aSmartCar/esp32driver-board/README.md

# ESP32Driver

This project is part of the ASV system and includes the custom PCB

## Specs
- Powersupply: 5.5 V - 36 V (depends on the voltage resistors)
- Microcontroller: ESP32
- USB to UART: FTDI FT231XQ
- Motorcontroller: Sparkfun DUALTB6612FNG
