aSmartCar/esp32driver-board/ESP32Driver_bottom.pdf

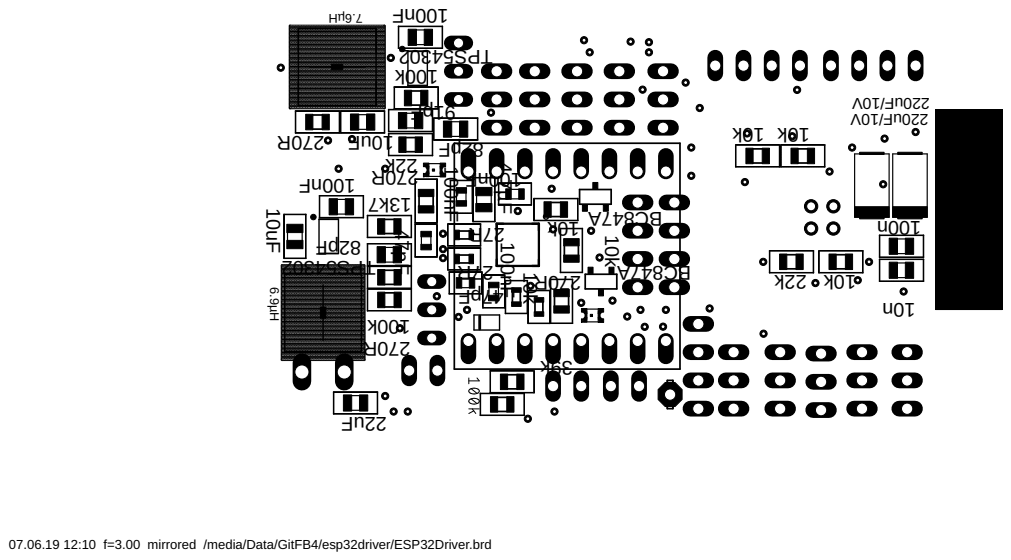
[picture p1: page 1]

07.06.19 12:10 f=3.00 mirrored /media/Data/GitFB4/esp32driver/ESP32Driver.brd
