aSmartCar/esp32driver-board/ESP32Driver_top.pdf

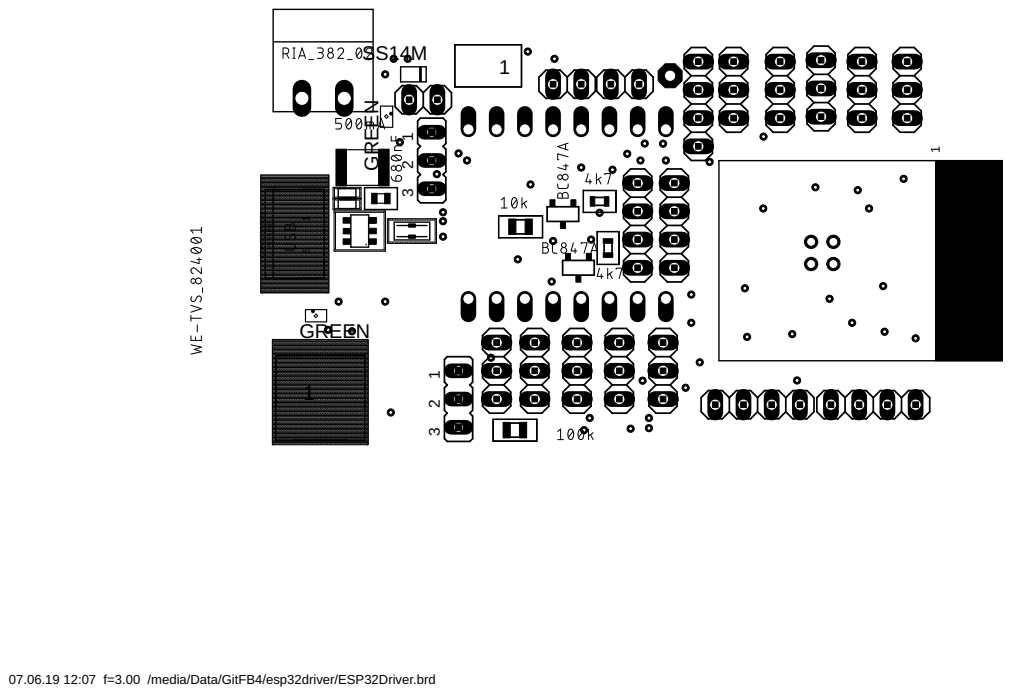
[picture p2: page 1]

PCB EDGE CONNECTOR EDGE 1
