aSmartCar/esp32driver-board/ESP32Driver.brd

## EAGLE design ESP32Driver.brd (2021-08-10)

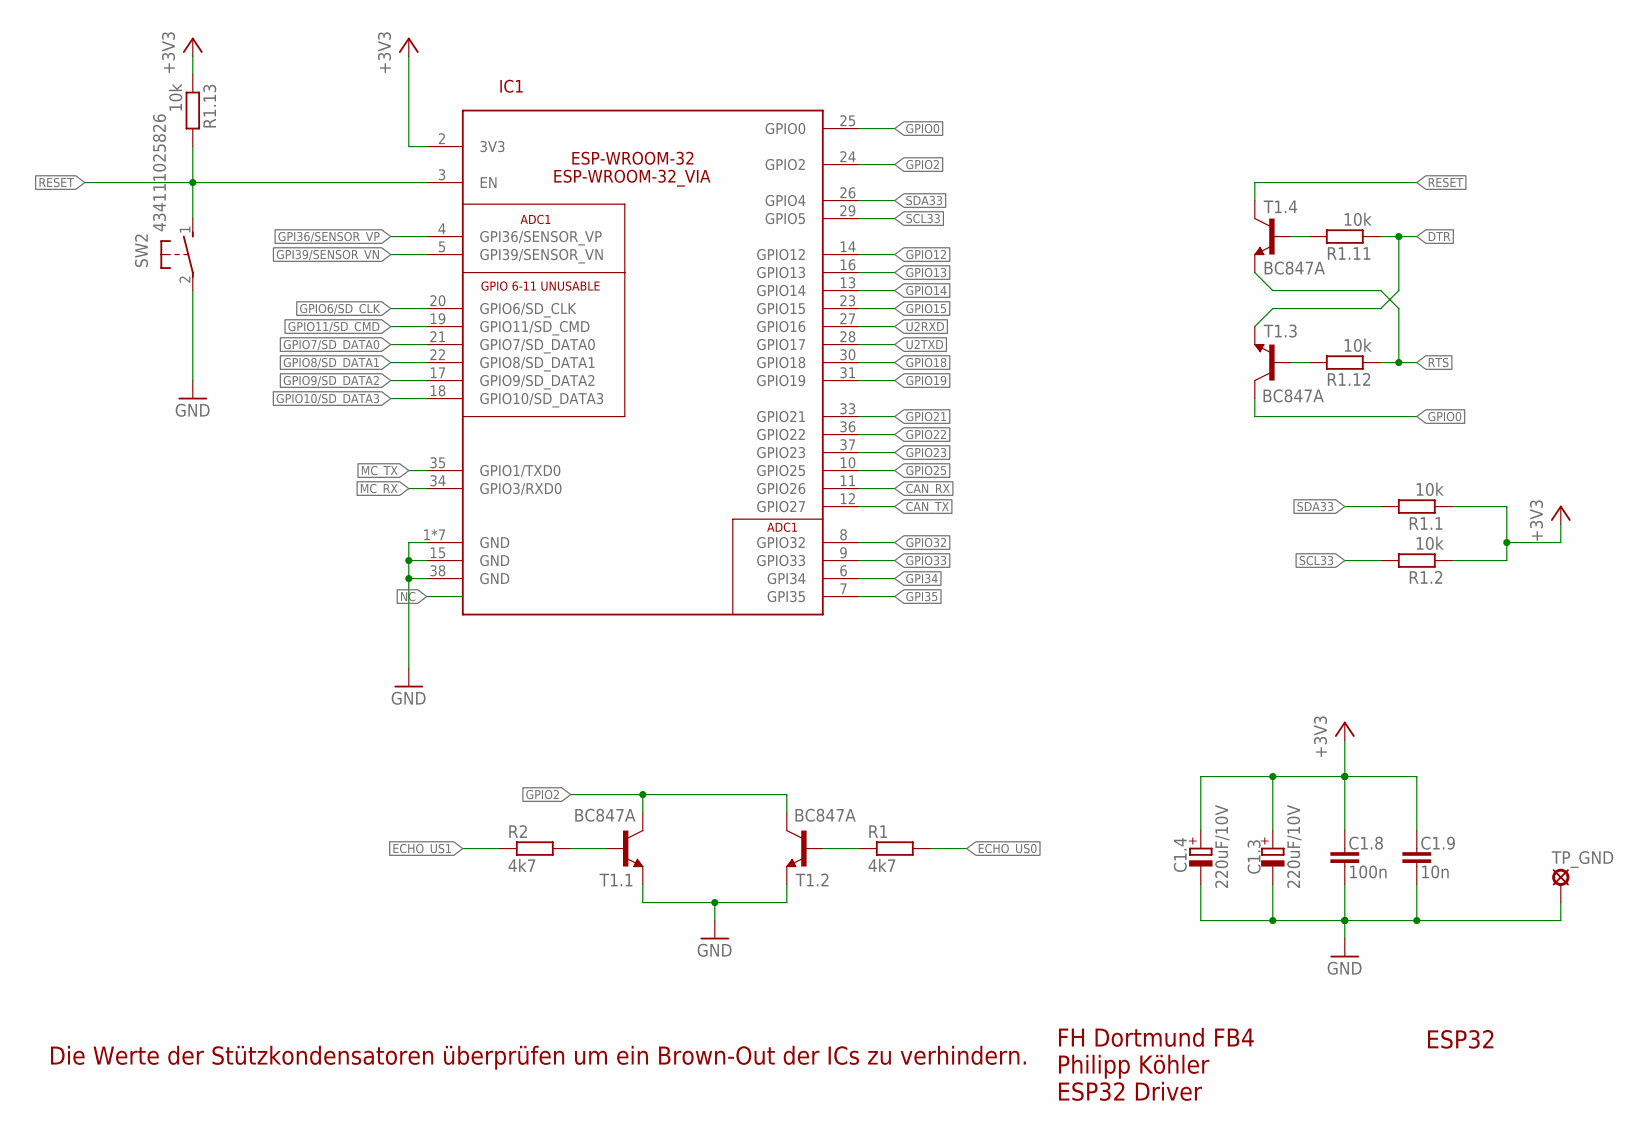
[picture p3: schematic ESP32Driver.sch, sheet 1, ESP32]

Parts:
C1.3, C1.4: 220uF/10V; SMC_C
C1.8: 100n; C0805
C1.9: 10n; C0805
IC1: ESP-WROOM-32_VIA; ESP-WROOM-32-VIA
R1, R2: 4k7; R0603
R1.1, R1.2, R1.11, R1.12, R1.13: 10k; R0805
SW2: 434111025826; 434121025816
T1.1, T1.2, T1.3, T1.4: BC847A; SOT23
TP_GND: GND; LSP10

Connections:
+3V3: C1.3.+, C1.4.+, C1.8.1, C1.9.1, IC1.2 (3V3), R1.1.1, R1.2.1, R1.13.1; also elsewhere on the board
CAN_RX: IC1.11 (GPIO26); also elsewhere on the board
CAN_TX: IC1.12 (GPIO27); also elsewhere on the board
DTR: R1.11.1, T1.3.2 (E); also elsewhere on the board
ECHO_US0: R1.2; also elsewhere on the board
ECHO_US1: R2.1; also elsewhere on the board
GND: C1.3.-, C1.4.-, C1.8.2, C1.9.2, IC1.1 (GND), IC1.15 (GND), IC1.38 (GND), IC1.THERMAL (GND), IC1.THERMAL1 (GND), IC1.T_VIA1 (GND), IC1.T_VIA2 (GND), IC1.T_VIA3 (GND), IC1.T_VIA4 (GND), SW2.2, T1.1.2 (E), T1.2.2 (E), TP_GND.MP; also elsewhere on the board
GPI34: IC1.6 (GPI34); also elsewhere on the board
GPI35: IC1.7 (GPI35); also elsewhere on the board
GPI36/SENSOR_VP: IC1.4 (GPI36/SENSOR_VP); also elsewhere on the board
GPI39/SENSOR_VN: IC1.5 (GPI39/SENSOR_VN); also elsewhere on the board
GPIO0: IC1.25 (GPIO0), T1.3.3 (C); also elsewhere on the board
GPIO2: IC1.24 (GPIO2), T1.1.3 (C), T1.2.3 (C)
GPIO6/SD_CLK: IC1.20 (GPIO6/SD_CLK)
GPIO7/SD_DATA0: IC1.21 (GPIO7/SD_DATA0)
GPIO8/SD_DATA1: IC1.22 (GPIO8/SD_DATA1)
GPIO9/SD_DATA2: IC1.17 (GPIO9/SD_DATA2)
GPIO10/SD_DATA3: IC1.18 (GPIO10/SD_DATA3)
GPIO11/SD_CMD: IC1.19 (GPIO11/SD_CMD)
GPIO12: IC1.14 (GPIO12); also elsewhere on the board
GPIO13: IC1.16 (GPIO13); also elsewhere on the board
GPIO14: IC1.13 (GPIO14); also elsewhere on the board
GPIO15: IC1.23 (GPIO15); also elsewhere on the board
GPIO18: IC1.30 (GPIO18); also elsewhere on the board
GPIO19: IC1.31 (GPIO19); also elsewhere on the board
GPIO21: IC1.33 (GPIO21); also elsewhere on the board
GPIO22: IC1.36 (GPIO22); also elsewhere on the board
GPIO23: IC1.37 (GPIO23); also elsewhere on the board
GPIO25: IC1.10 (GPIO25); also elsewhere on the board
GPIO32: IC1.8 (GPIO32); also elsewhere on the board
GPIO33: IC1.9 (GPIO33); also elsewhere on the board
MC_RX: IC1.34 (GPIO3/RXD0); also elsewhere on the board
MC_TX: IC1.35 (GPIO1/TXD0); also elsewhere on the board
unnamed: R1.1, T1.2.1 (B)
unnamed: R2.2, T1.1.1 (B)
unnamed: R1.12.2, T1.3.1 (B)
unnamed: R1.11.2, T1.4.1 (B)
NC: IC1.32 (NC)
RESET: IC1.3 (EN), R1.13.2, SW2.1, T1.4.3 (C)
RTS: R1.12.1, T1.4.2 (E); also elsewhere on the board
SCL33: IC1.29 (GPIO5), R1.2.2; also elsewhere on the board
SDA33: IC1.26 (GPIO4), R1.1.2; also elsewhere on the board
U2RXD: IC1.27 (GPIO16); also elsewhere on the board
U2TXD: IC1.28 (GPIO17); also elsewhere on the board

Notes on the sheet:
Die Werte der Stützkondensatoren überprüfen um ein Brown-Out der ICs zu verhindern.
GPIO 6-11 UNUSABLE
ESP32
FH Dortmund FB4 Philipp Köhler ESP32 Driver
ADC1

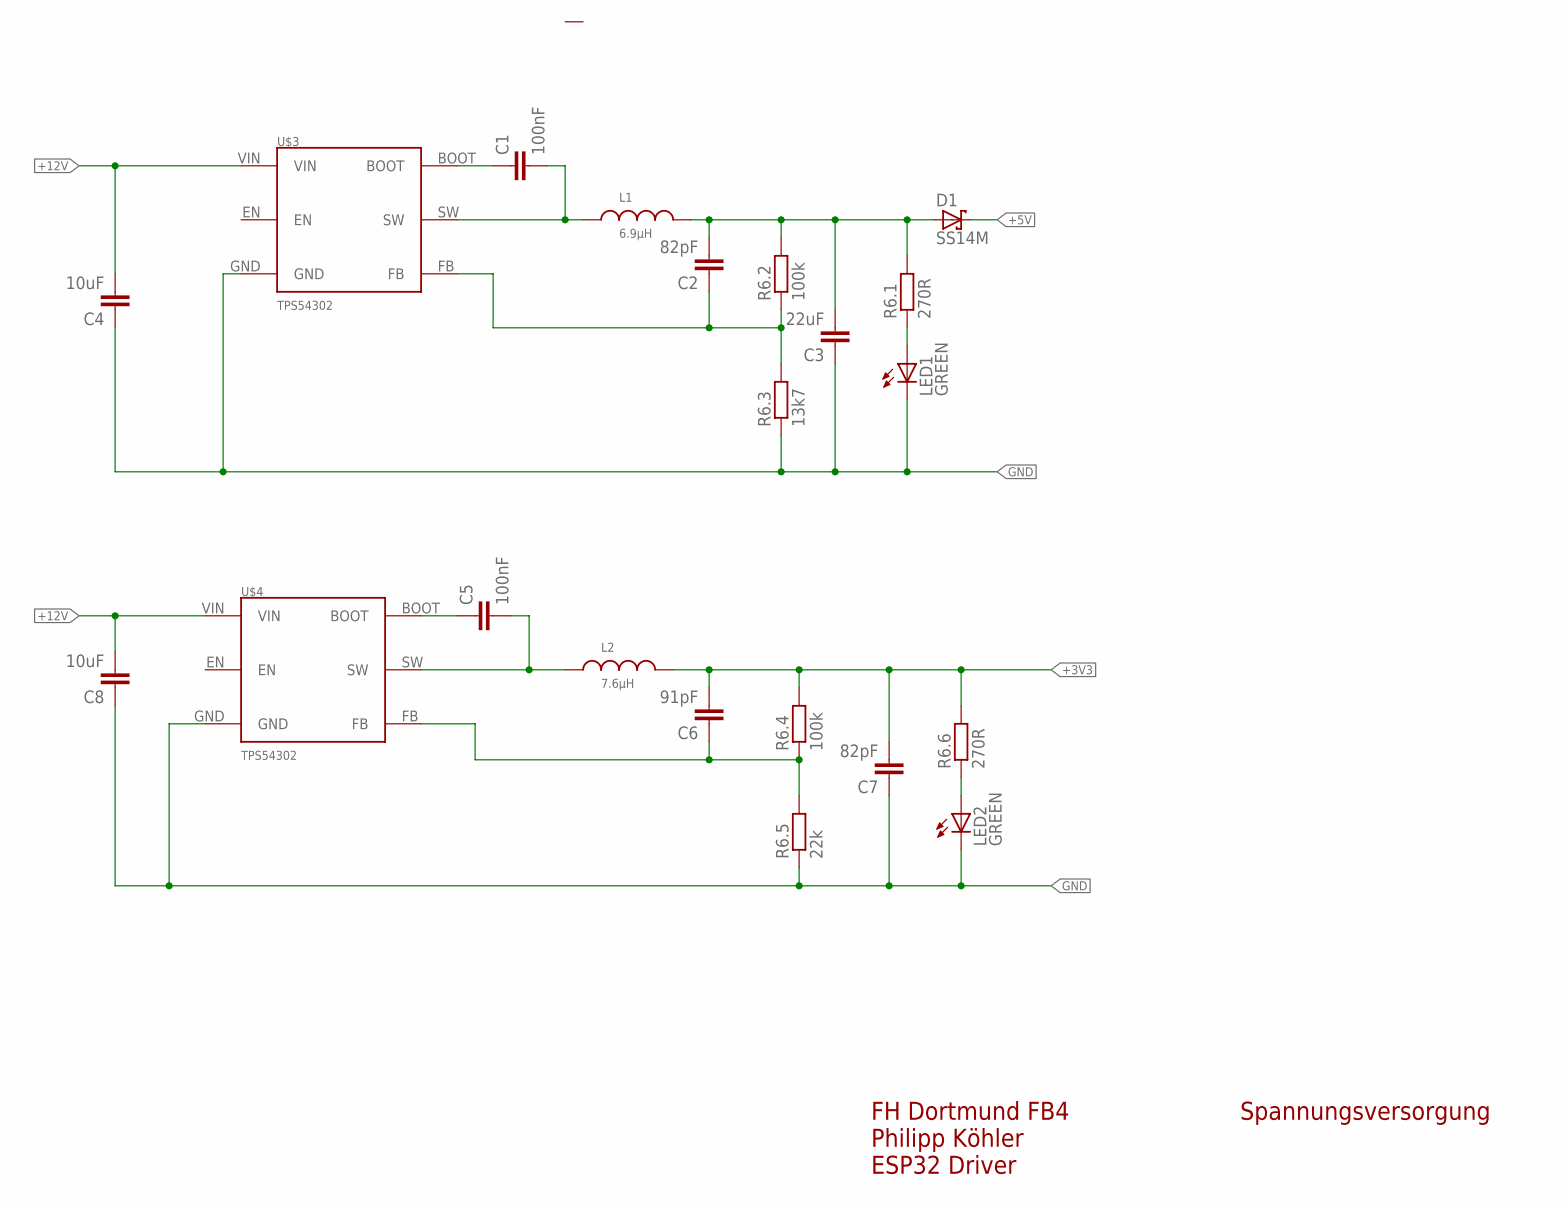
[picture p4: schematic ESP32Driver.sch, sheet 2, Spannungsversorgung]

Parts:
C1, C5: 100nF; C0805
C2, C7: 82pF; C0805
C3: 22uF; C0805
C4, C8: 10uF; C0805
C6: 91pF; C0805
D1: SS14M; MICRO-SMA
L1: 6.9µH; WE-HCI_7030/7040/7050
L2: 7.6µH; WE-HCI_7030/7040/7050
LED1, LED2: GREEN; SML0805
R6.1, R6.6: 270R; R0805
R6.2, R6.4: 100k; R0805
R6.3: 13k7; R0805
R6.5: 22k; R0805
U$3, U$4: TPS54302; SOT95P280X110-6

Connections:
+3V3: C6.2, C7.2, L2.2, R6.4.2, R6.6.2; also elsewhere on the board
+5V: D1.1 (C); also elsewhere on the board
+12V: C4.2, C8.2, U$3.VIN, U$4.VIN; also elsewhere on the board
GND: C3.1, C4.1, C7.1, C8.1, LED1.C, LED2.C, R6.3.1, R6.5.1, U$3.GND, U$4.GND; also elsewhere on the board
unnamed: C2.2, C3.2, D1.2 (A), L1.2, R6.1.2, R6.2.2
unnamed: C1.1, U$3.BOOT
unnamed: C1.2, L1.1, U$3.SW
unnamed: C2.1, R6.2.1, R6.3.2, U$3.FB
unnamed: C5.1, U$4.BOOT
unnamed: LED1.A, R6.1.1
unnamed: C5.2, L2.1, U$4.SW
unnamed: C6.1, R6.4.1, R6.5.2, U$4.FB
unnamed: LED2.A, R6.6.1

Notes on the sheet:
Spannungsversorgung
FH Dortmund FB4 Philipp Köhler ESP32 Driver

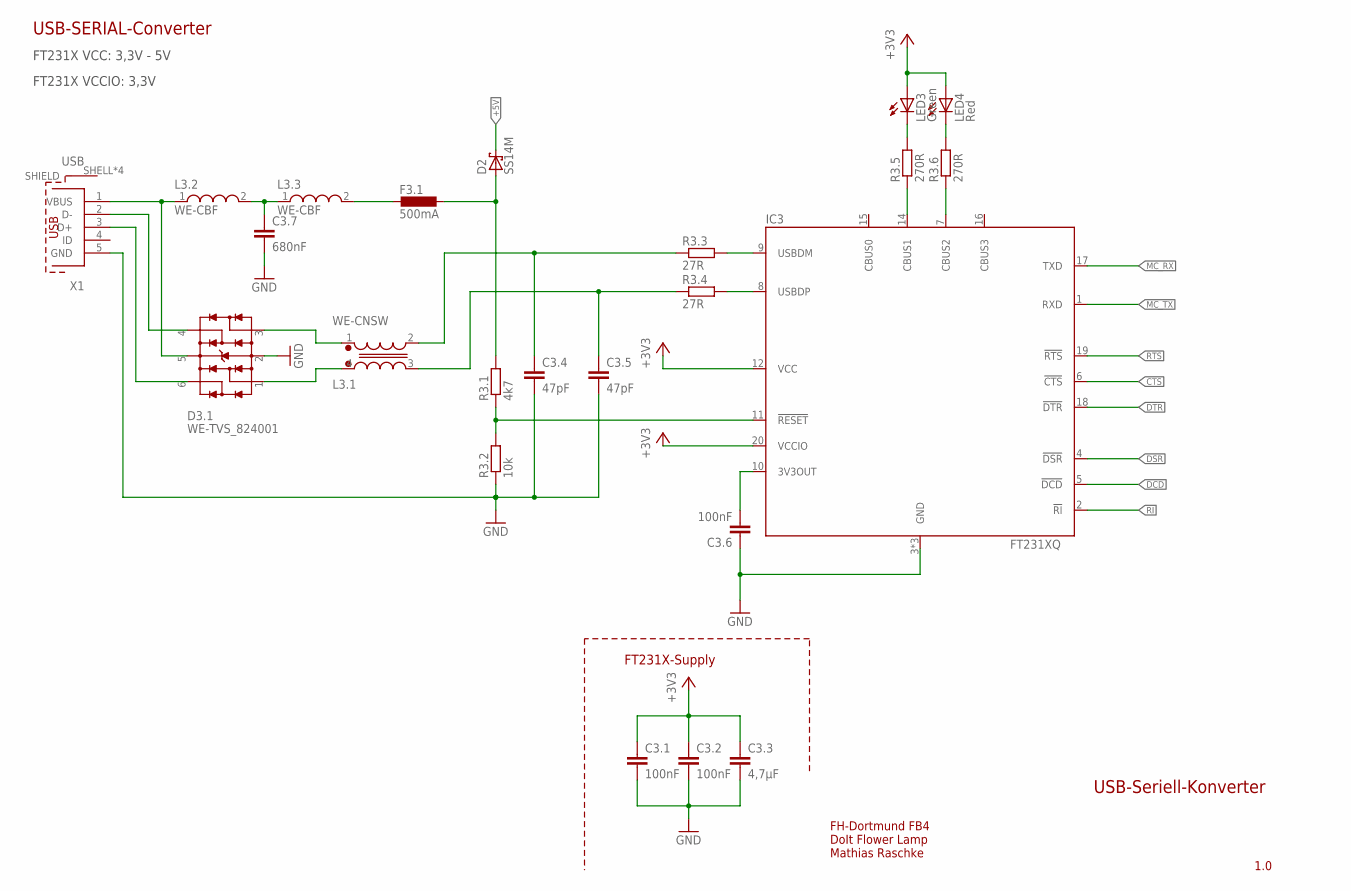
[picture p5: schematic ESP32Driver.sch, sheet 3, USB-Serial-Converter]

Parts:
C3.1, C3.2, C3.6: 100nF; C0603
C3.3: 4,7µF; C0805
C3.4, C3.5: 47pF; C0603
C3.7: 680nF; C0603
D2: SS14M; MICRO-SMA
D3.1: WE-TVS_824001; WE-TVS_SOT23-6L
F3.1: 500mA; L1812
IC3: FT231XQ; QFN20
L3.1: WE-CNSW; WE-CNSW_1206
L3.2, L3.3: WE-CBF; WE-CBF_0603(W=2.2)
LED3: Green; CHIPLED_0805
LED4: Red; CHIPLED_0805
R3.1: 4k7; R0603
R3.2: 10k; R0603
R3.3, R3.4: 27R; R0603
R3.5, R3.6: 270R; R0805
X1: USB; 629105136821

Connections:
3V3OUT: C3.6.2, IC3.10 (3V3OUT)
+3V3: C3.1.1, C3.2.1, C3.3.1, IC3.12 (VCC), IC3.20 (VCCIO), LED3.A, LED4.A; also elsewhere on the board
+5V: D2.1 (C); also elsewhere on the board
CTS: IC3.6 (!CTS)
DCD: IC3.5 (!DCD)
DSR: IC3.4 (!DSR)
DTR: IC3.18 (!DTR); also elsewhere on the board
GND: C3.1.2, C3.2.2, C3.3.2, C3.4.2, C3.5.2, C3.6.1, C3.7.2, D3.1.2 (GND), IC3.3 (GND), IC3.13 (GND), IC3.EXP (GND), R3.2.1, X1.5 (GND); also elsewhere on the board
MC_RX: IC3.17 (TXD); also elsewhere on the board
MC_TX: IC3.1 (RXD); also elsewhere on the board
unnamed: IC3.14 (CBUS1), R3.5.1
unnamed: IC3.7 (CBUS2), R3.6.1
unnamed: LED3.C, R3.5.2
unnamed: LED4.C, R3.6.2
unnamed: IC3.8 (USBDP), R3.4.2
unnamed: IC3.9 (USBDM), R3.3.2
unnamed: C3.5.1, L3.1.3 (2), R3.4.1
unnamed: C3.4.1, L3.1.2 (3), R3.3.1
unnamed: IC3.11 (!RESET), R3.1.1, R3.2.2
unnamed: D3.1.1, L3.1.4 (1)
unnamed: D3.1.3 (2), L3.1.1 (4)
unnamed: C3.7.1, L3.2.2, L3.3.1
unnamed: D3.1.5 (VDD), L3.2.1, X1.1 (VBUS)
unnamed: F3.1.2, L3.3.2
RI: IC3.2 (!RI)
RTS: IC3.19 (!RTS); also elsewhere on the board
VUSB: D2.2 (A), F3.1.1, R3.1.2
_N: D3.1.4 (3), X1.2 (D-)
_P: D3.1.6 (4), X1.3 (D+)

Notes on the sheet:
FT231X VCC: 3,3V - 5V
FT231X VCCIO: 3,3V
USB-SERIAL-Converter
FT231X-Supply
1.0
USB-Seriell-Konverter
FH-Dortmund FB4 DoIt Flower Lamp Mathias Raschke

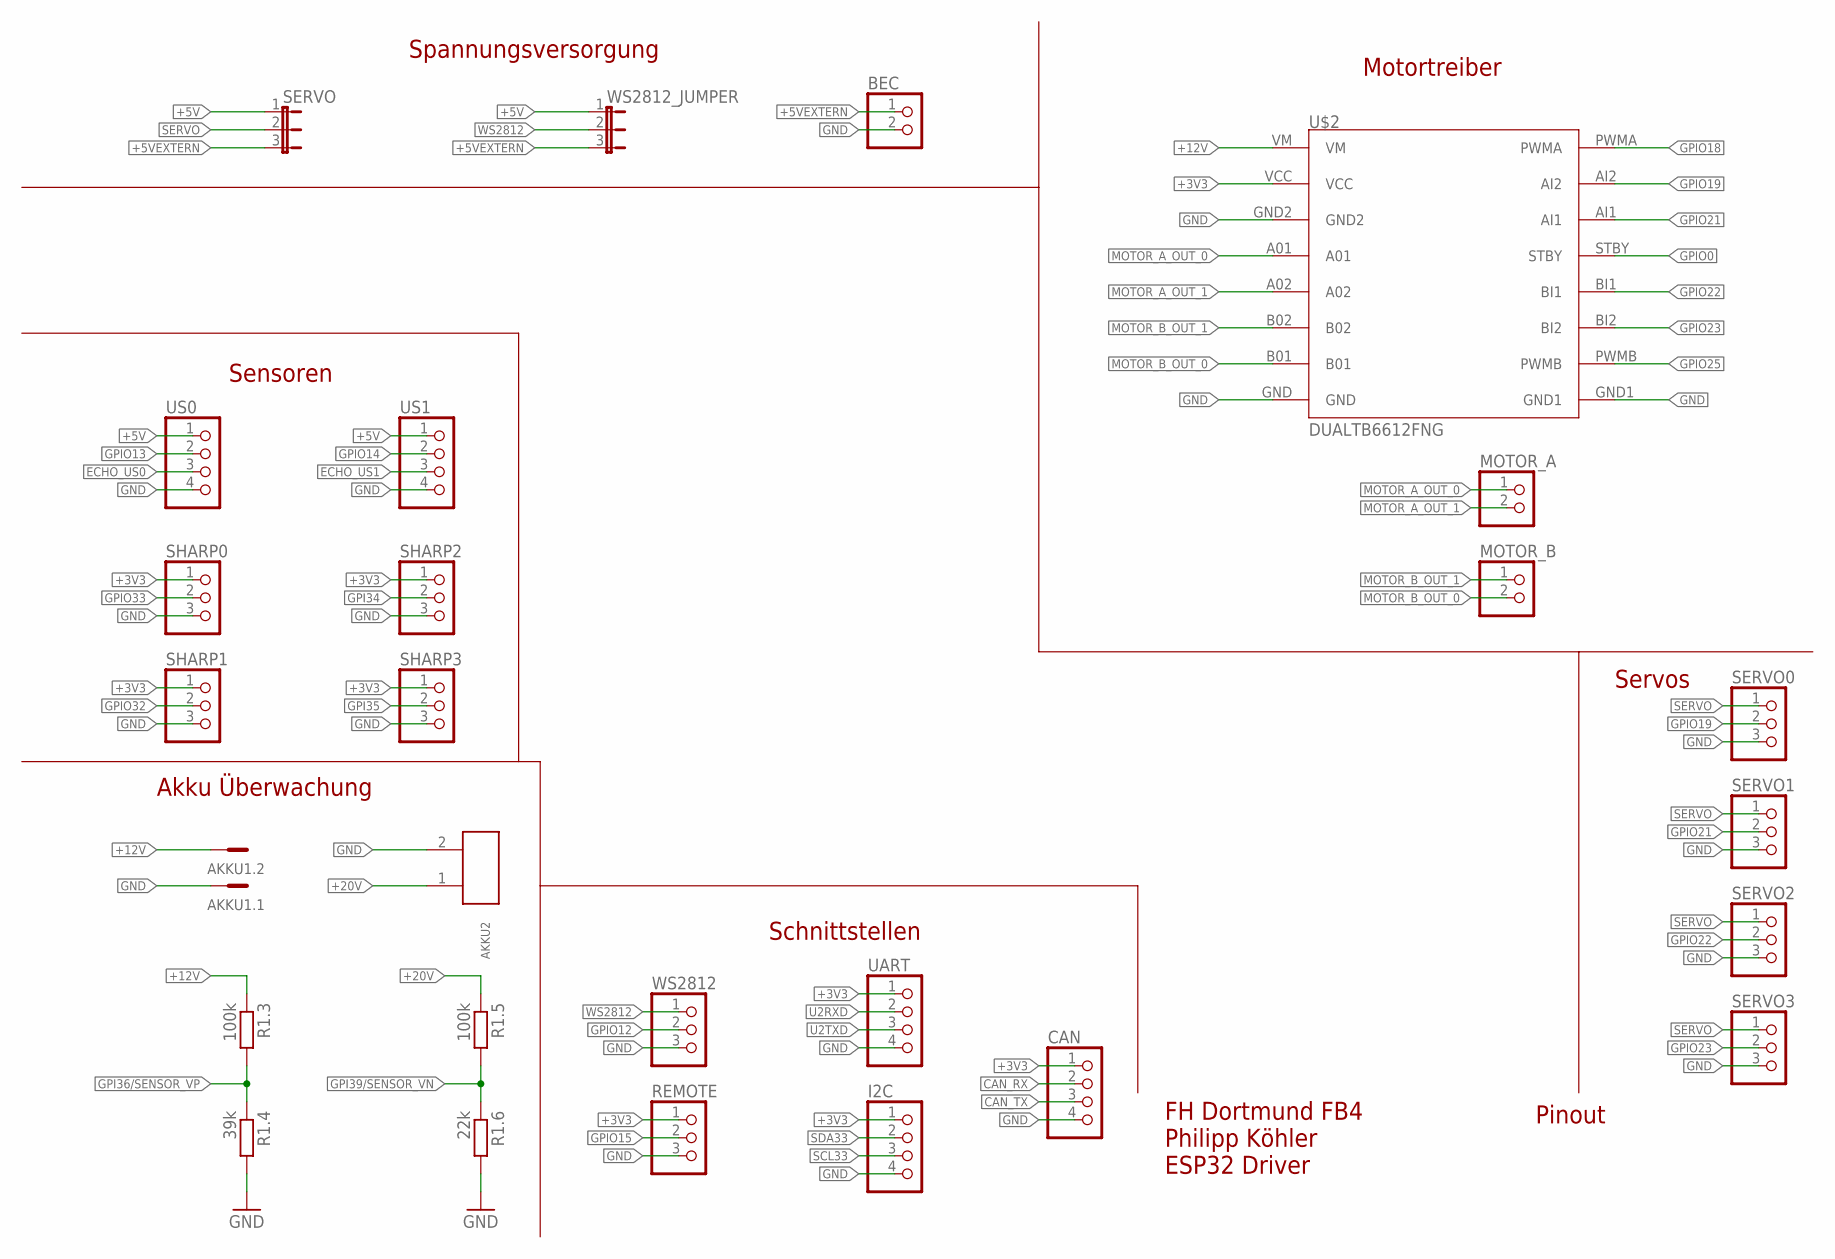
[picture p6: schematic ESP32Driver.sch, sheet 4, Pinout]

Parts:
AKKU1: RIA_382_02; 382_02
AKKU2: 620102131822
BEC: PINHD-1X2; 1X02
CAN: PINHD-1X4; 1X04
I2C: PINHD-1X4; 1X04
MOTOR_A: PINHD-1X2; 1X02
MOTOR_B: PINHD-1X2; 1X02
R1.3, R1.5: 100k; R0805
R1.4: 39k; R0805
R1.6: 22k; R0805
REMOTE: PINHD-1X3; 1X03
SERVO: JP2E; JP2
SERVO0, SERVO1, SERVO2, SERVO3: PINHD-1X3; 1X03
SHARP0, SHARP1, SHARP2, SHARP3: PINHD-1X3; 1X03
U$2: DUALTB6612FNG
UART: PINHD-1X4; 1X04
US0, US1: PINHD-1X4; 1X04
WS2812: PINHD-1X3; 1X03
WS2812_JUMPER: JP2E; JP2

Connections:
+3V3: CAN.1, I2C.1, REMOTE.1, SHARP0.1, SHARP1.1, SHARP2.1, SHARP3.1, U$2.VCC, UART.1; also elsewhere on the board
+5V: SERVO.1, US0.1, US1.1, WS2812_JUMPER.1; also elsewhere on the board
+5VEXTERN: BEC.1, SERVO.3, WS2812_JUMPER.3
+12V: AKKU1.2, R1.3.1, U$2.VM; also elsewhere on the board
+20V: AKKU2.1 (2), R1.5.1
CAN_RX: CAN.2; also elsewhere on the board
CAN_TX: CAN.3; also elsewhere on the board
ECHO_US0: US0.3; also elsewhere on the board
ECHO_US1: US1.3; also elsewhere on the board
GND: AKKU1.1, AKKU2.2 (1), BEC.2, CAN.4, I2C.4, R1.4.2, R1.6.2, REMOTE.3, SERVO0.3, SERVO1.3, SERVO2.3, SERVO3.3, SHARP0.3, SHARP1.3, SHARP2.3, SHARP3.3, U$2.GND, U$2.GND1, U$2.GND2, UART.4, US0.4, US1.4, WS2812.3; also elsewhere on the board
GPI34: SHARP2.2; also elsewhere on the board
GPI35: SHARP3.2; also elsewhere on the board
GPI36/SENSOR_VP: R1.3.2, R1.4.1; also elsewhere on the board
GPI39/SENSOR_VN: R1.5.2, R1.6.1; also elsewhere on the board
GPIO0: U$2.STBY; also elsewhere on the board
GPIO12: WS2812.2; also elsewhere on the board
GPIO13: US0.2; also elsewhere on the board
GPIO14: US1.2; also elsewhere on the board
GPIO15: REMOTE.2; also elsewhere on the board
GPIO18: U$2.PWMA; also elsewhere on the board
GPIO19: SERVO0.2, U$2.AI2; also elsewhere on the board
GPIO21: SERVO1.2, U$2.AI1; also elsewhere on the board
GPIO22: SERVO2.2, U$2.BI1; also elsewhere on the board
GPIO23: SERVO3.2, U$2.BI2; also elsewhere on the board
GPIO25: U$2.PWMB; also elsewhere on the board
GPIO32: SHARP1.2; also elsewhere on the board
GPIO33: SHARP0.2; also elsewhere on the board
MOTOR_A_OUT_0: MOTOR_A.1, U$2.A01
MOTOR_A_OUT_1: MOTOR_A.2, U$2.A02
MOTOR_B_OUT_0: MOTOR_B.2, U$2.B01
MOTOR_B_OUT_1: MOTOR_B.1, U$2.B02
SCL33: I2C.3; also elsewhere on the board
SDA33: I2C.2; also elsewhere on the board
SERVO: SERVO.2, SERVO0.1, SERVO1.1, SERVO2.1, SERVO3.1
U2RXD: UART.2; also elsewhere on the board
U2TXD: UART.3; also elsewhere on the board
WS2812: WS2812.1, WS2812_JUMPER.2

Notes on the sheet:
Pinout
Motortreiber
Servos
Spannungsversorgung
Akku Überwachung
Sensoren
Schnittstellen
FH Dortmund FB4 Philipp Köhler ESP32 Driver

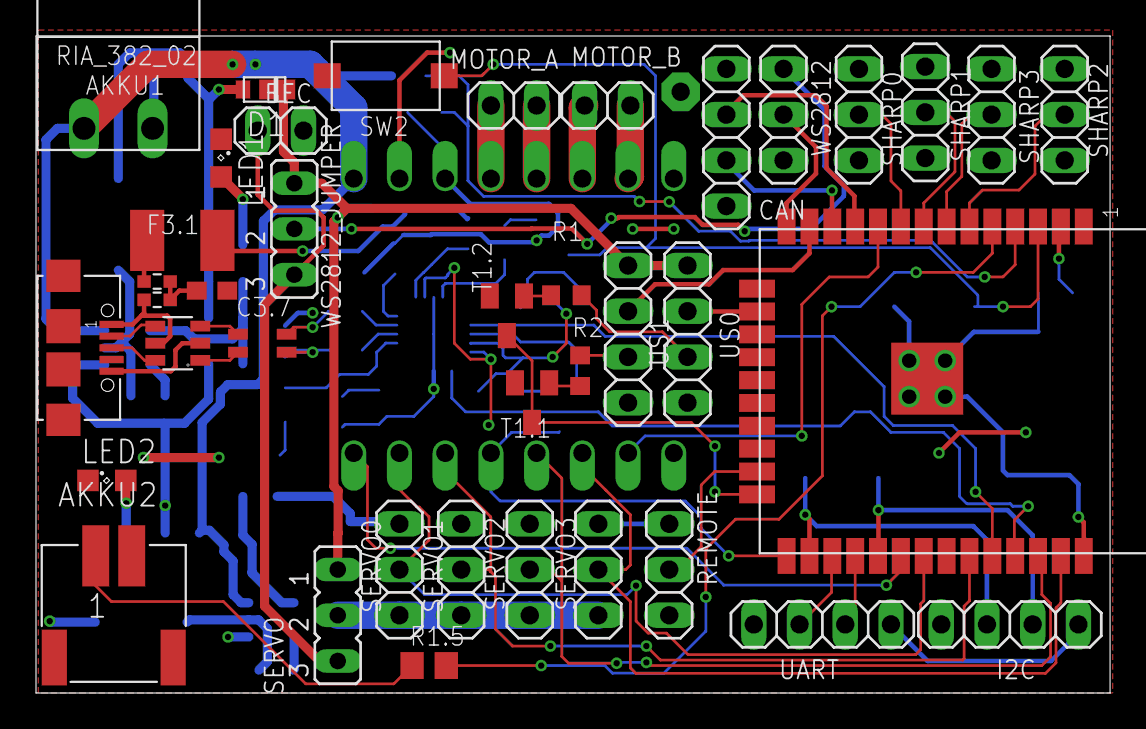
[picture p7: board ESP32Driver.brd from above]

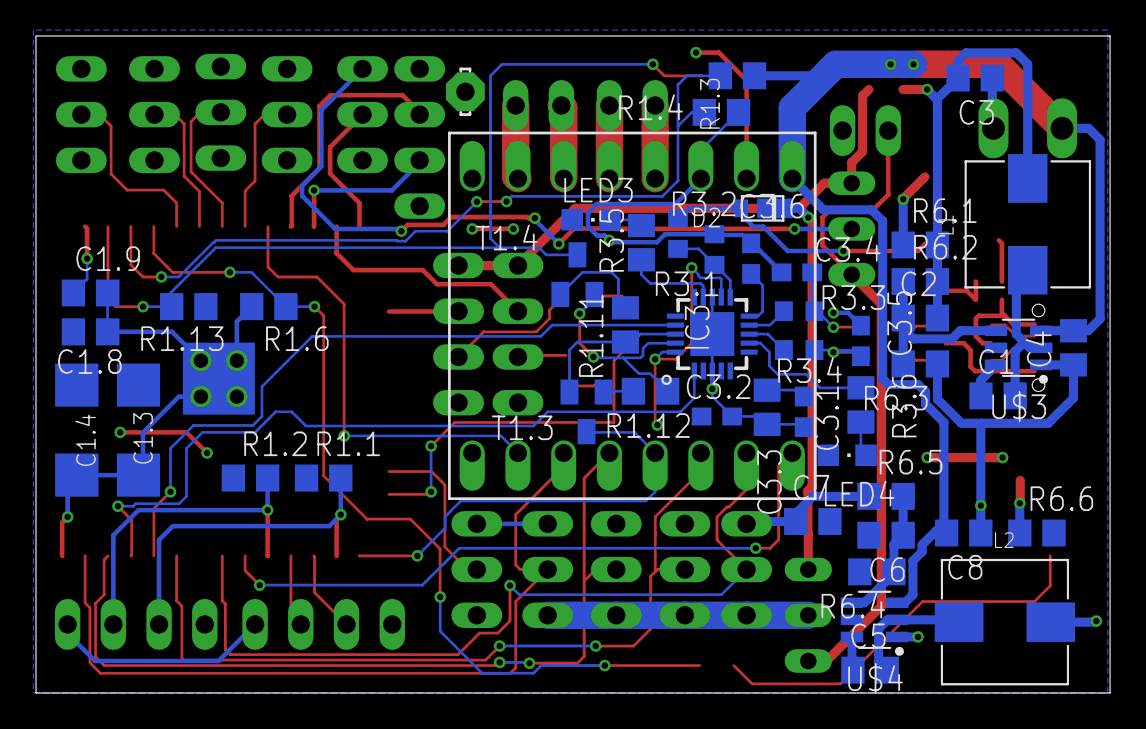
[picture p8: board ESP32Driver.brd from below]

Board: 2 copper layers, 59.7 x 36.5 mm, 89 parts (50 on the bottom side), 74 nets.
