aSmartCar/esp32driver-board/(notices)

Notices in the files:
parts and their libraries:
Wurth_Elektronik_Passive_rev15d: Copyright: Würth Elektronik
